JYment/WS2812B_Light_Animation/Bluetooth_Speaker/짙은스튜디오_자연을 담은 감성 LED 액자조명.pdf

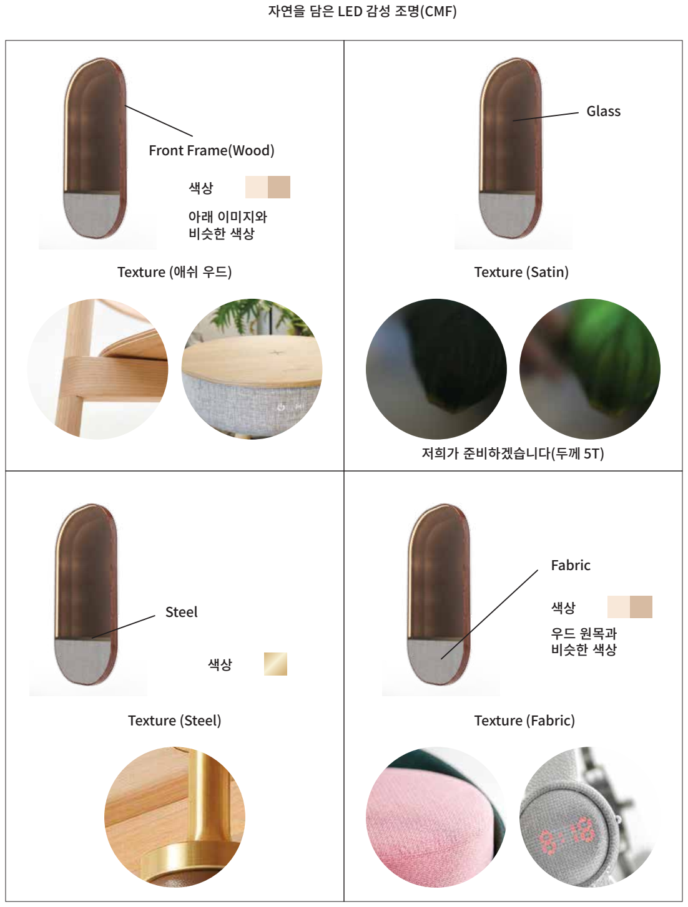
[picture p1: page 1]

Glass

Steel

Fabric

Texture (애쉬우드)

아래이미지와
비슷한색상

우드원목과
비슷한색상

Texture (Steel)

자연을담은 LED 감성조명(CMF)

Front Frame(Wood)

Texture (Satin)

저희가준비하겠습니다(두께 5T)

Texture (Fabric)

색상

색상

색상

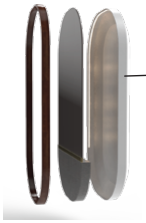
[picture p2: figure]

Back Frame(abs)

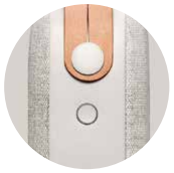
[picture p3: figure]

Button

Texture(abs)

아래이미지와
비슷한색상

색상
전선

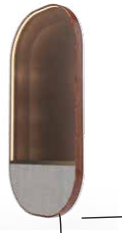
[picture p4: figure]

Texture(Fabric)

작동
0. 콘센트연결

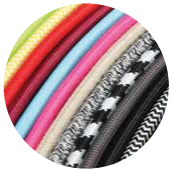
[picture p5: figure]

1. ON - 전원버튼을누른다 >>> LED 기본 MODE ON(*스피커연결 X)
2. 전원버튼꾸욱누른다 >>> 블루투스페어링 ON
(*연결되기전연결음, LED 파란불깜빡깜빡 / 연결된후연결음, LED 파란불 ON)
3. 메인LED 버튼길게누르고있는다 >>> 디밍기능 - 불어두워짐 다시길게누르고있는다 >>> 디밍기능 - 불밝아짐
4. 메인LED 버튼한번누른다
>>> LED Animation(일렁임)으로변경 (*4번이랑같은디밍기능가능하도록)
5. 메인LED 버튼한번더누른다(*총 2번)
>>> LED OFF
6. 메인LED 꺼진상태에서버튼누른다
>>> 다시기본모드 ON
7. 타이머버튼한번누른다 >>> 30분후전원 OFF(*신호 LED 색상)
8. 타이머버튼한번더누른다(*총 2번) >>> 60분후전원 OFF(*신호 LED 색상)
9. 타이머버튼한번더누른다(*총 3번) >>> 타이머기능 OFF
10. OFF - 전원버튼 누른다

버튼
1. 전원 / 2. LED / 3. 타이머
위치
Fabirc 앞면

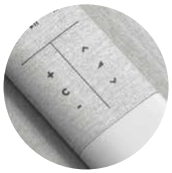
[picture p6: figure]

* 아이콘은 디자인해서
내드리겠습니다.

비슷한제품보여드리겠습니다.
