JYment/WS2812B_Light_Animation/Bluetooth_Speaker/circuit/BT_speaker/BT_speaker.kicad_pcb

## KiCad design Bluetooth_Speaker/circuit/BT_speaker/BT_speaker.kicad_pcb (2019-12-17)

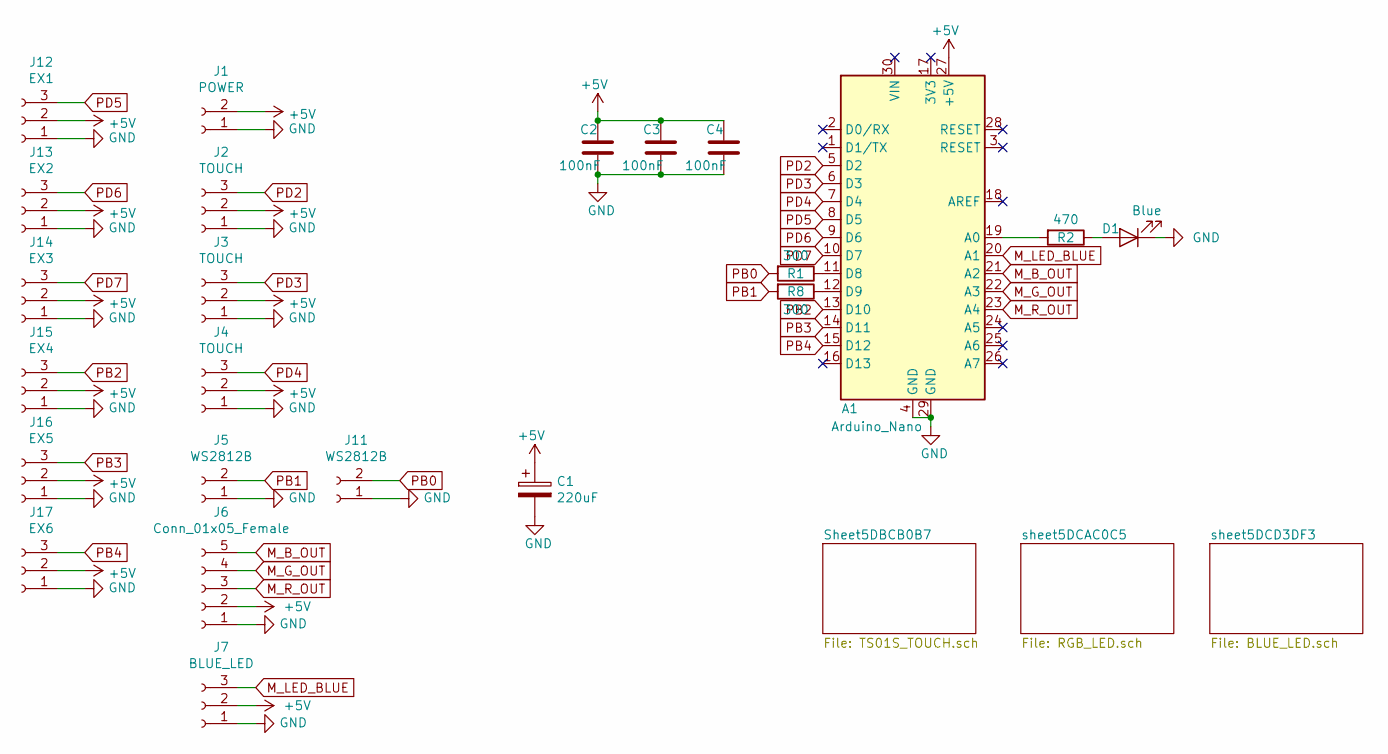
[picture p7: schematic BT_speaker.sch]

Parts:
A1: Arduino_Nano
C1: 220uF; CP_Radial_D10.0mm_P5.00mm
C2, C3, C4: 100nF; C_0603_1608Metric
D1: Blue; LED_0603_1608Metric_Pad1.05x0.95mm_HandSolder
J1: POWER; Molex_SPOX_5267-02A_1x02_P2.50mm_Vertical
J2, J3, J4: TOUCH; Molex_SPOX_5267-03A_1x03_P2.50mm_Vertical
J5, J11: WS2812B; Molex_SPOX_5267-02A_1x02_P2.50mm_Vertical
J6: Conn_01x05_Female; Molex_SPOX_5267-05A_1x05_P2.50mm_Vertical
J7: BLUE_LED; Molex_SPOX_5267-03A_1x03_P2.50mm_Vertical
J12: EX1; Molex_SPOX_5267-03A_1x03_P2.50mm_Vertical
J13: EX2; Molex_SPOX_5267-03A_1x03_P2.50mm_Vertical
J14: EX3; Molex_SPOX_5267-03A_1x03_P2.50mm_Vertical
J15: EX4; Molex_SPOX_5267-03A_1x03_P2.50mm_Vertical
J16: EX5; Molex_SPOX_5267-03A_1x03_P2.50mm_Vertical
J17: EX6; Molex_SPOX_5267-03A_1x03_P2.50mm_Vertical
R1, R8: 300; R_0603_1608Metric
R2: 470; R_0603_1608Metric

Connections:
+5V: A1.27 (+5V), C1.1, C2.1, C3.1, C4.1, J1.2, J2.2, J3.2, J4.2, J6.2, J7.2, J12.2, J13.2, J14.2, J15.2, J16.2, J17.2
GND: A1.4 (GND), A1.29 (GND), C1.2, C2.2, C3.2, C4.2, D1.1 (K), J1.1, J2.1, J3.1, J4.1, J5.1, J6.1, J7.1, J11.1, J12.1, J13.1, J14.1, J15.1, J16.1, J17.1
M_B_OUT: A1.21 (A2), J6.5
M_G_OUT: A1.22 (A3), J6.4
M_LED_BLUE: A1.20 (A1), J7.3
M_R_OUT: A1.23 (A4), J6.3
unnamed: A1.11 (D8), R1.1
unnamed: A1.12 (D9), R8.1
unnamed: A1.19 (A0), R2.2
unnamed: D1.2 (A), R2.1
PB0: J11.2, R1.2
PB1: J5.2, R8.2
PB2: A1.13 (D10), J15.3
PB3: A1.14 (D11), J16.3
PB4: A1.15 (D12), J17.3
PD2: A1.5 (D2), J2.3
PD3: A1.6 (D3), J3.3
PD4: A1.7 (D4), J4.3
PD5: A1.8 (D5), J12.3
PD6: A1.9 (D6), J13.3
PD7: A1.10 (D7), J14.3

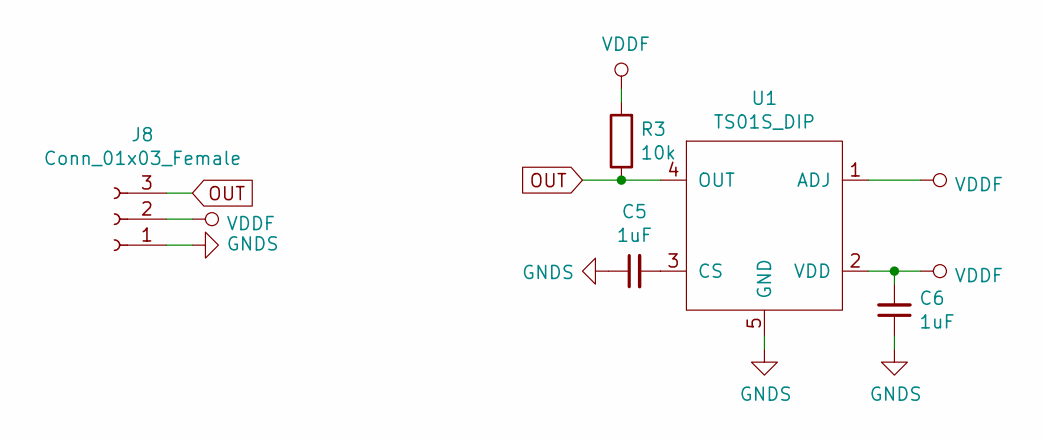
[picture p8: schematic TS01S_TOUCH.sch]

Parts:
C5, C6: 1uF; C_0603_1608Metric
J8: Conn_01x03_Female; Molex_SPOX_5267-03A_1x03_P2.50mm_Vertical
R3: 10k; R_0603_1608Metric
U1: TS01S_DIP; DS01S_DIP_SiliconType

Connections:
GNDS: C5.1, C6.1, J8.1, U1.5 (GND)
unnamed: C5.2, U1.3 (CS)
OUT: J8.3, R3.1, U1.4 (OUT)
VDDF: C6.2, J8.2, R3.2, U1.1 (ADJ), U1.2 (VDD)

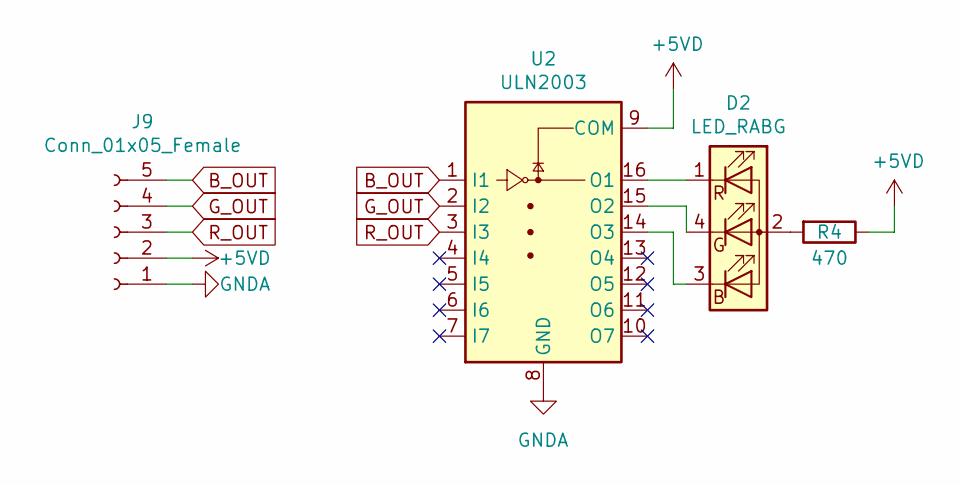
[picture p9: schematic RGB_LED.sch]

Parts:
D2: LED_RABG; LED_D5.0mm-4_RGB
J9: Conn_01x05_Female; Molex_SPOX_5267-05A_1x05_P2.50mm_Vertical
R4: 470; R_0603_1608Metric
U2: ULN2003; SOIC-16_4.55x10.3mm_P1.27mm

Connections:
+5VD: J9.2, R4.1, U2.9 (COM)
B_OUT: J9.5, U2.1 (I1)
GNDA: J9.1, U2.8 (GND)
G_OUT: J9.4, U2.2 (I2)
unnamed: D2.1 (RK), U2.16 (O1)
unnamed: D2.2 (A), R4.2
unnamed: D2.3 (BK), U2.14 (O3)
unnamed: D2.4 (GK), U2.15 (O2)
R_OUT: J9.3, U2.3 (I3)

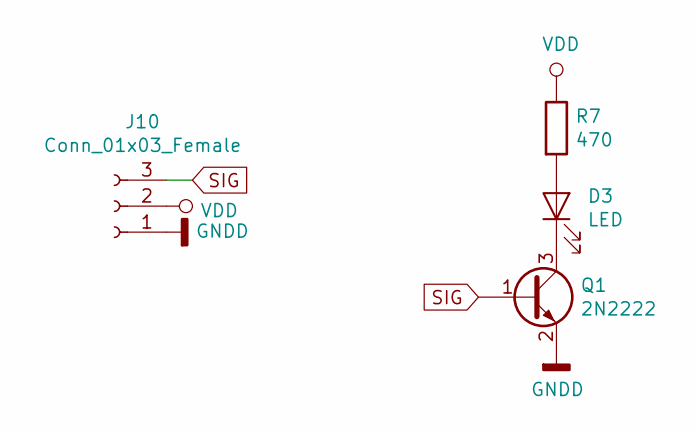
[picture p10: schematic BLUE_LED.sch]

Parts:
D3: LED; LED_0603_1608Metric_Pad1.05x0.95mm_HandSolder
J10: Conn_01x03_Female; Molex_SPOX_5267-03A_1x03_P2.50mm_Vertical
Q1: 2N2222; SOT-23
R7: 470; R_0603_1608Metric

Connections:
GNDD: J10.1, Q1.2 (E)
unnamed: D3.1 (K), Q1.3 (C)
unnamed: D3.2 (A), R7.2
SIG: J10.3, Q1.1 (B)
VDD: J10.2, R7.1

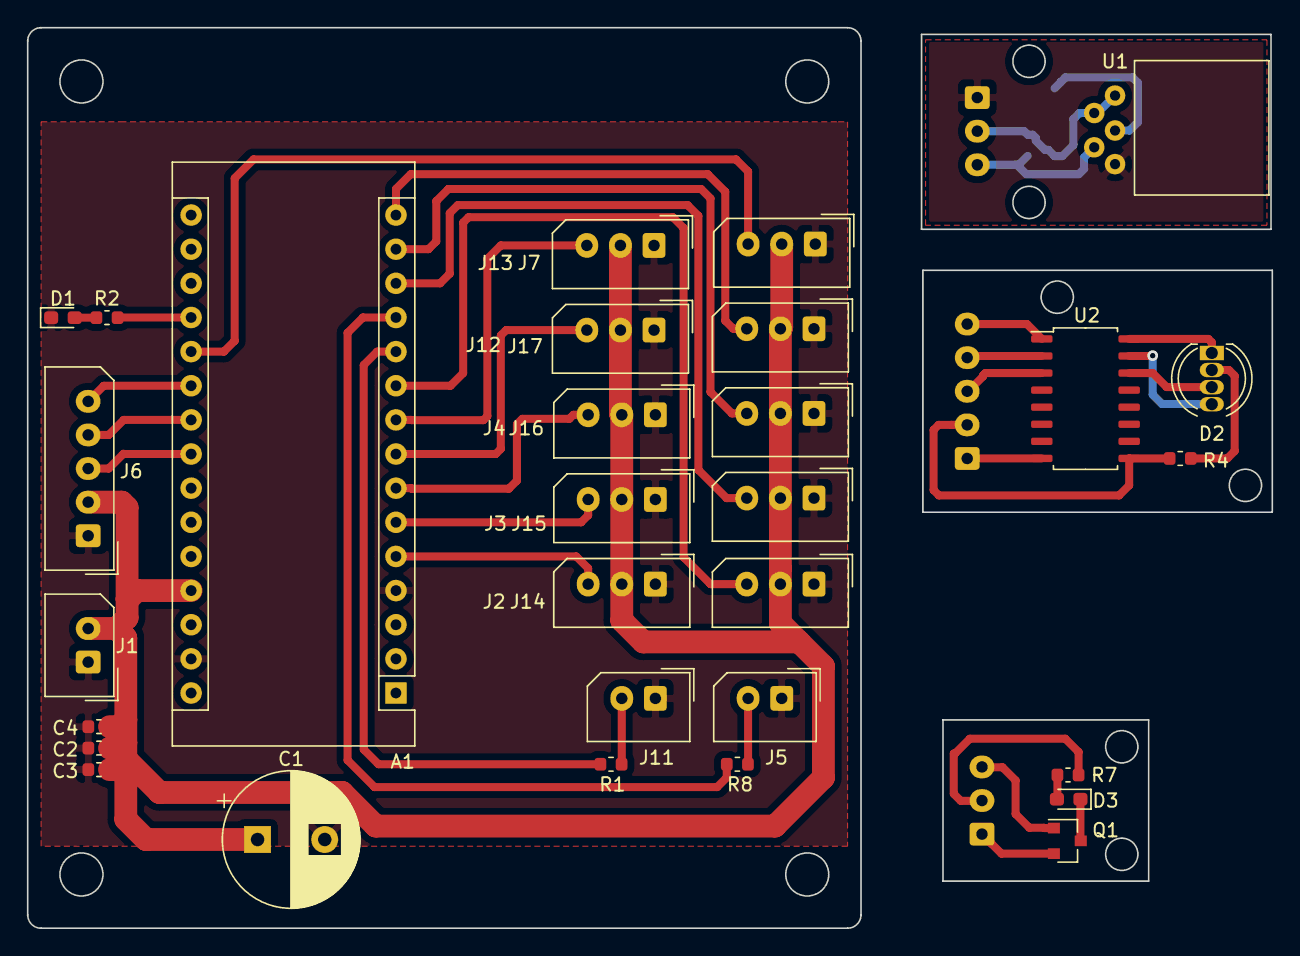
[picture p11: board BT_speaker.kicad_pcb from above]

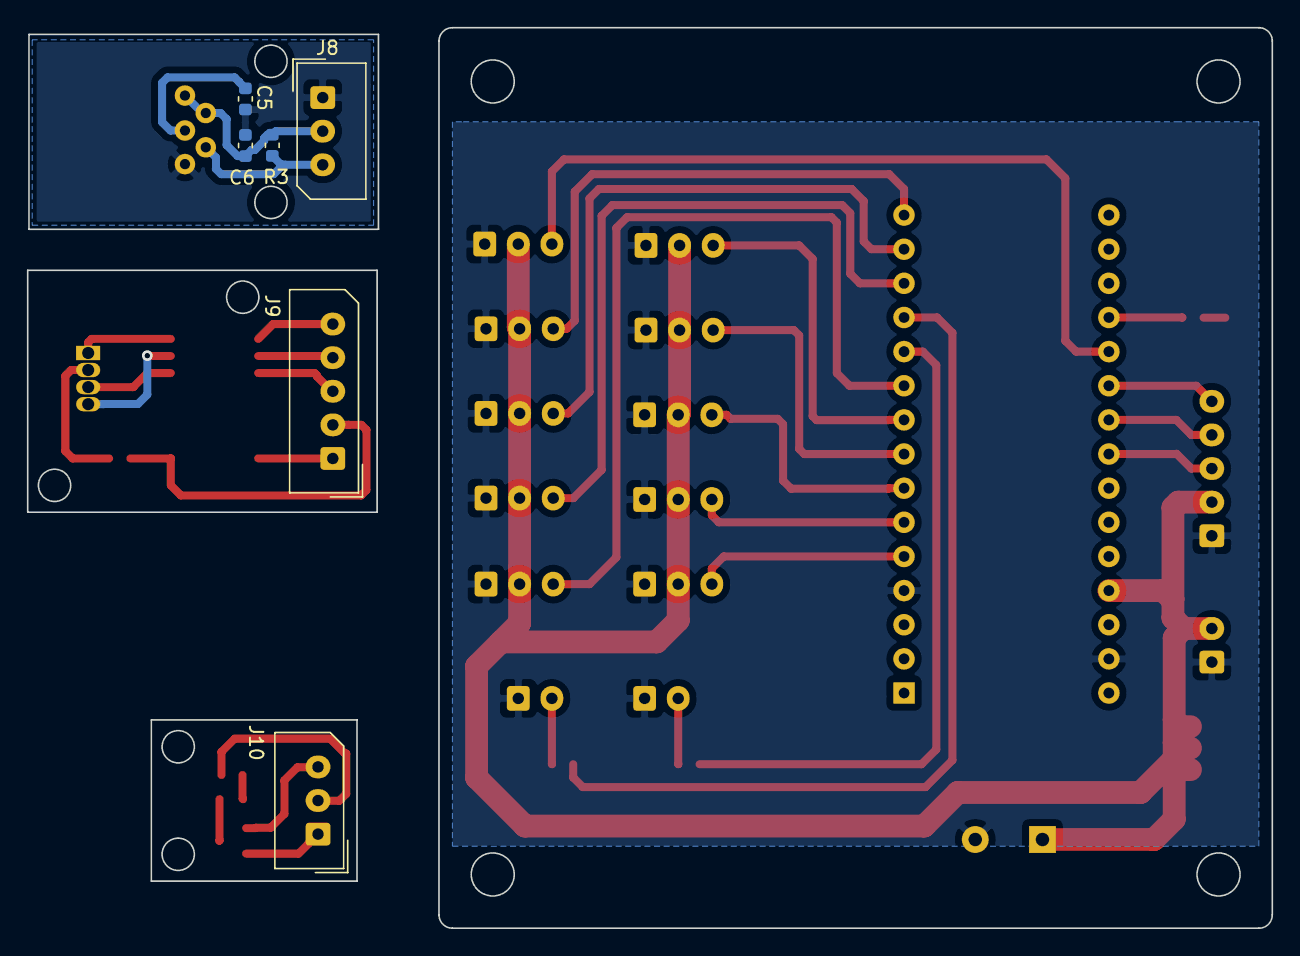
[picture p12: board BT_speaker.kicad_pcb from below]

Board: 2 copper layers, 92.6 x 67.0 mm, 36 parts (6 on the bottom side), 39 nets.
