JYment/WS2812B_Light_Animation/Bluetooth_Speaker/firmware/stm_ws2812b.ioc

Mcu.UserName=STM32F103RETx
PA13.Signal=SYS_JTMS-SWDIO
PA14.Signal=SYS_JTCK-SWCLK
PA6.Signal=S_TIM3_CH1
PD0-OSC_IN.Signal=RCC_OSC_IN
PD1-OSC_OUT.Signal=RCC_OSC_OUT
