JYment/WS2812B_Light_Animation/Bluetooth_Speaker/firmware/Src/main.c

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

/* Includes ------------------------------------------------------------------*/
#include "main.h"
#include "dma.h"
#include "tim.h"
#include "gpio.h"

/* USER CODE BEGIN Includes */
#define LED 100
uint8_t buf[LED*24+48] = {
    57,57,57,57,57,57,57,57,28,28,28,28,28,28,28,28,28,28,28,28,28,28,28,28, // Green
    28,28,28,28,28,28,28,28,57,57,57,57,57,57,57,57,28,28,28,28,28,28,28,28, // Red
    28,28,28,28,28,28,28,28,28,28,28,28,28,28,28,28,57,57,57,57,57,57,57,57, // Blue
    57,57,57,57,57,57,57,57,57,57,57,57,57,57,57,57,57,57,57,57,57,57,57,57, // White
    0,0,0,0,0,0,0,0,0,0,0,0,0,0,0,0,0,0,0,0,0,0,0,0,0,0,0,0,0,0,0,0,0,0,0,0,0,0,0,0,0,0,0,0,0,0,0,0
};

extern DMA_HandleTypeDef hdma_tim3_ch1_trig;
/* USER CODE END Includes */


/* USER CODE BEGIN PV */
void convert_color(uint32_t color, uint16_t led_no){ // GRB
    for(int i=0; i<24; i++){
        if(color&(1<<(23-i))) buf[led_no*24 + i] = 57;
        else                  buf[led_no*24 + i] = 28;
    }
}

/* USER CODE END PV */

void SystemClock_Config(void);
/**
  * @brief  The application entry point.
  * @retval int
  */
int main(void)
{
  

  /* MCU Configuration--------------------------------------------------------*/

  /* Reset of all peripherals, Initializes the Flash interface and the Systick. */
  HAL_Init();

  /* Configure the system clock */
  SystemClock_Config();

  /* Initialize all configured peripherals */
  MX_GPIO_Init();
  MX_DMA_Init();
  MX_TIM3_Init();
  /* USER CODE BEGIN 2 */
  HAL_TIM_PWM_Stop_DMA(&htim3, TIM_CHANNEL_1);
  HAL_TIM_PWM_Start_DMA(&htim3, TIM_CHANNEL_1, (uint32_t*)buf, LED*24+48);
  while(hdma_tim3_ch1_trig.Instance->CNDTR > 0);
  HAL_Delay(1000);

  memset(buf, 0, LED*24+48);

  /* USER CODE END 2 */

  /* Infinite loop */
  /* USER CODE BEGIN WHILE */
  while (1)
  {
    /* USER CODE END WHILE */

    /* USER CODE BEGIN 3 */

	  for(int i=0; i<100; i++){
		  convert_color(0x7FFFFFFF, i);
	  }
	  HAL_TIM_PWM_Start_DMA(&htim3, TIM_CHANNEL_1, (uint32_t*)buf, LED*24+48);
	  while(hdma_tim3_ch1_trig.Instance->CNDTR > 0);
	  HAL_Delay(100);

  }
  /* USER CODE END 3 */
}

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
