JYment/WS2812B_Light_Animation/Bluetooth_Speaker/firmware/ws2812b_ATmega328/GccApplication1/GccApplication1/common.h

/*
 * def.h
 *
 * Created: 2019-03-06 오전 11:04:10
 *  Author: Jae
 */ 


#ifndef DEF_H_
#define DEF_H_

#define F_CPU		16000000UL
#include <avr/io.h>
#include <avr/interrupt.h>
#include <util/delay.h>
#include <stdio.h>
#include <string.h>
#include "ATmega328_USART.h"


#endif /* DEF_H_ */
